cyclotron-bonn/nano_util_board/README.md

# nano_util_board
PCB design of the Arduino Nano-based util carrier board
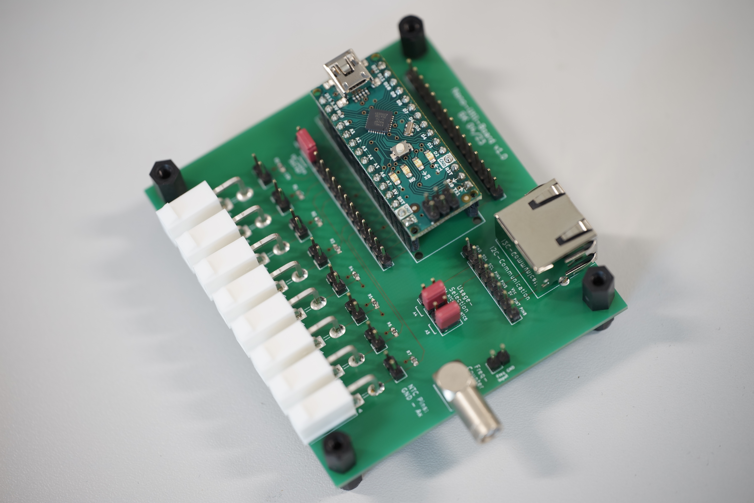
[picture p1: assets/Nano_util_board_v1_0_Birdeye.JPG]
nano_board_front


# KiCaD folder
This folder contains all the `.kicad_x` files necessary to display the schematic and pcb design in KiCaD.
A rendered 3d image `.png` of the PCB is also to be found in here, a `.pdf` of the schematic and a folder containing recent `.gbr` files.

# Further information
Information about the usage and programming can be found in the Wiki of this repository.
