cyclotron-bonn/nano_util_board/assets/Nano_util_board_v1_0_Topside_marked.JPG

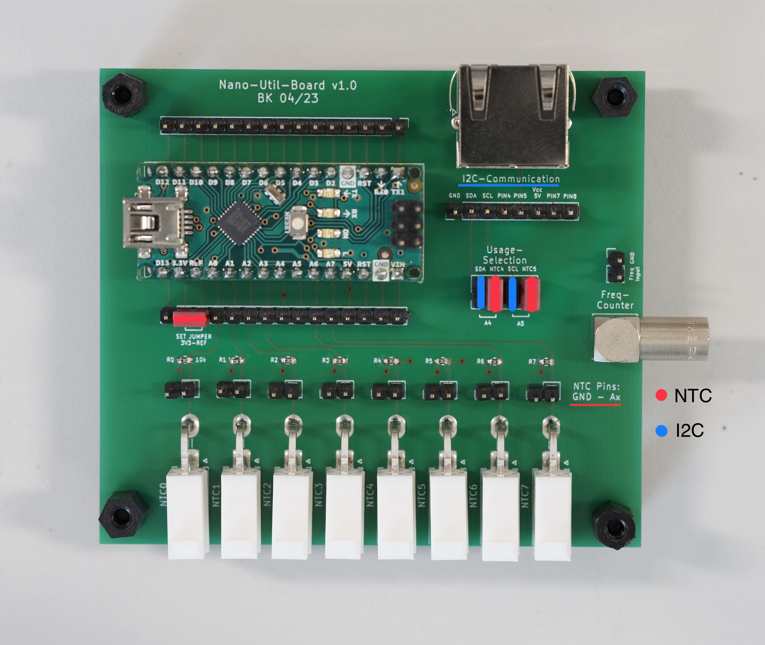
assets/Nano_util_board_v1_0_Topside_marked.JPG
