cyclotron-bonn/nano_util_board/KiCaD/nano_board/nano_board_back.png

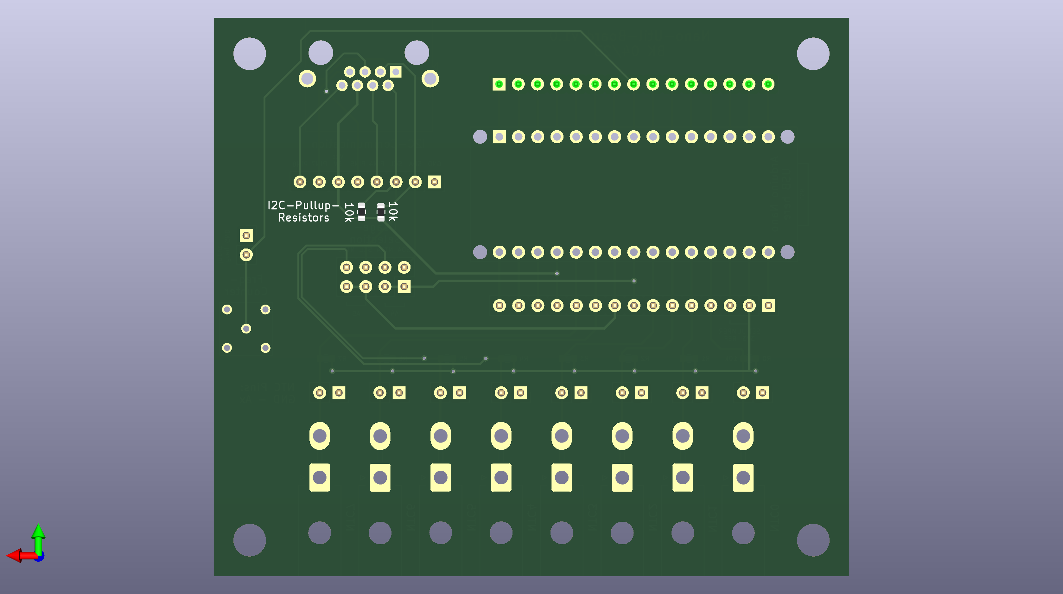
KiCaD/nano_board/nano_board_back.png
