cyclotron-bonn/nano_util_board/KiCaD/nano_board/nano_board.pdf

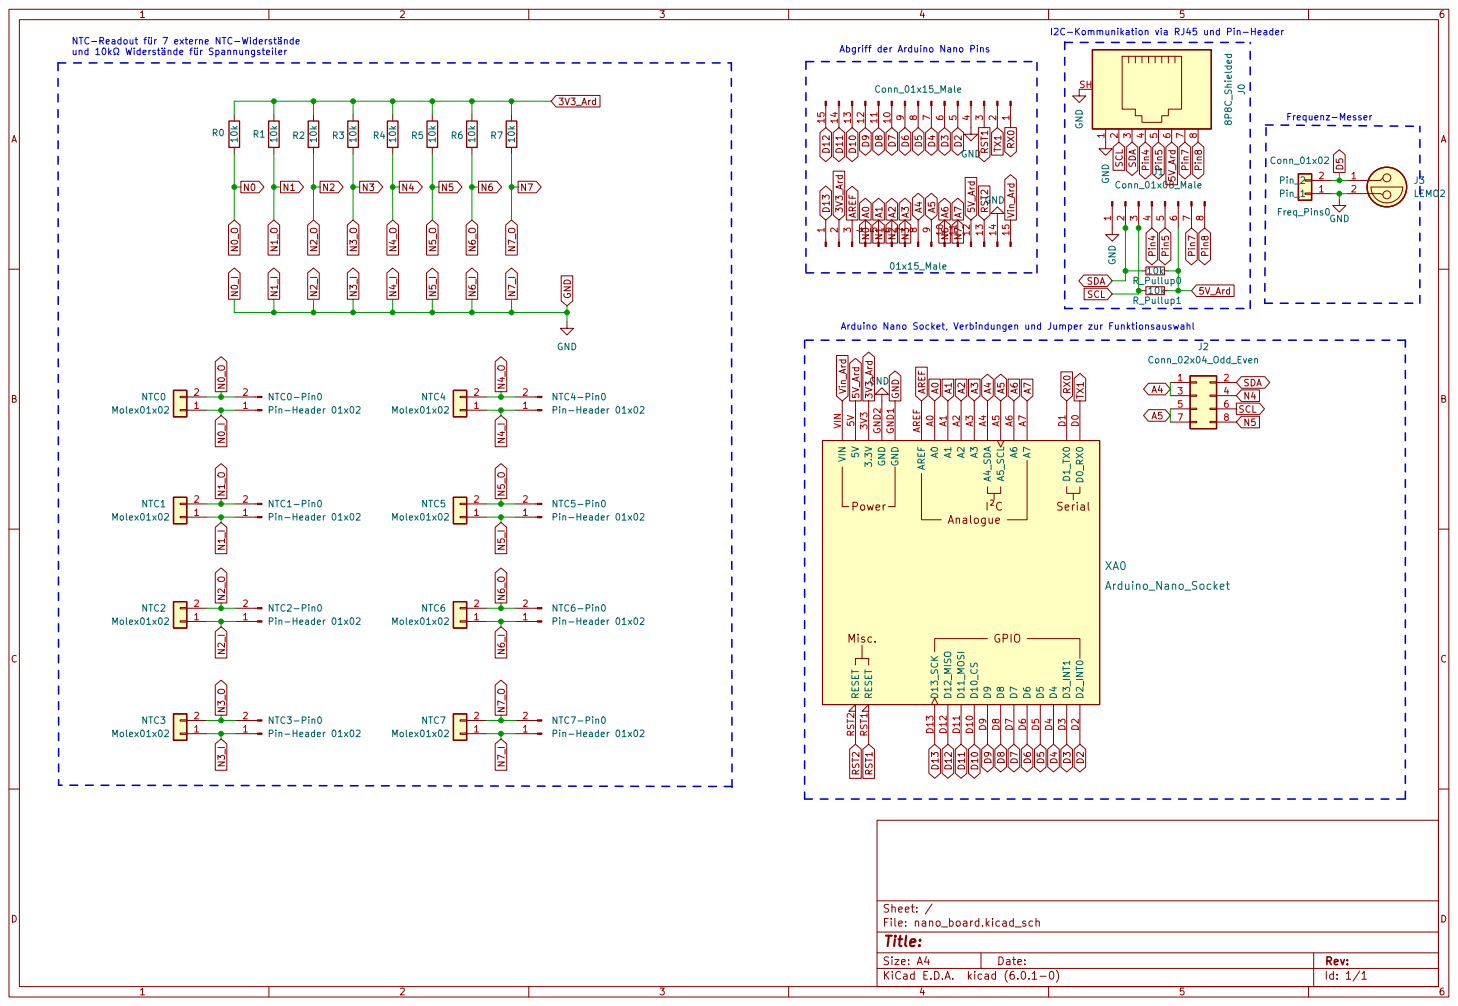
[picture p5: page 1]

Abgriff der Arduino Nano Pins þÿNTC-Readout für 7 externe NTC-Widerstände

I2C-Kommunikation via RJ45 und Pin-Header Arduino Nano Socket, Verbindungen und Jumper zur Funktionsauswahl
