cyclotron-bonn/nano_util_board/(threads)

Thread 1 (2022-08-31):

PCB: replace solder jumper with pin header

leloup314, 2022-08-31:
Replace the solder jumper which selects I2C VCC with a 3 pin header which then uses a jumper clip for selection

Closed 2022-09-02.

Thread 2 (2022-08-31):

PCB: add Lemo / BNC to connect freqency counting input

leloup314, 2022-08-31:
Additionally to the 2 pin header for the freq counter input, add a BNC / Lemo to connect to

bedakno, 2022-08-31:
Oh right, I forgot. Consider it done

Closed 2022-09-02.

Thread 3 (2022-08-31):

QUESTION: Resistor dimensions and arrangement of components

leloup314, 2022-08-31:
- Are you using 0603 footprints for the 10k resistors?
- Can you arrange the pin headers, that make all pins of the Nano available,  symmetrically around the Nano board?
- What is the current size of the PCB? Maybe you can make it a little bigger for the sake of accessibility when e.g. connecting NTCs

bedakno, 2022-08-31:
- yes
- ok, I rearranged most stuff so it fits onto a smaller PCB, but I guess accessability is important
- around 7.5x6 cm^2

Closed 2022-09-02.

Thread 4 (2022-08-31):

PCB: labels

leloup314, 2022-08-31:
Label e.g. the I2C pins individually with `VCC`, `GND`, `SDA`, and `SCL`. Label the Rj45 clearly as `R/O Board I2C Interface` or so, so people don't start to put random RJ45 cables in there ;)

Thread 6 (2022-09-02):

PCB: Sel-Pin-Freq Jumper not needed; VCC 3V3 to 5V needed

leloup314, 2022-09-02:
The Jumper Sel-Pin-Freq is not needed but it would be nice to set VCC of I2C to either 3V3 or 5V via such a jumper

Closed 2022-09-02.

Thread 8 (2022-09-02):

PCB: accessibility of PINs

leloup314, 2022-09-02:
The I2C Pin headers will not be easily accessible because of the adjacent RJ45 connector which is quite bulky, once on the PCB. Maybe you can relocate the I2C pin headers to be better accessible. It will be more easy to estimate if you place all the 3D components on the rendered image (if possible/available)

Closed 2022-09-02.

Thread 10 (2022-09-05):

PCB: Labels rename

leloup314, 2022-09-05:
- The I2C VCC select jumper should be named: `VCC select` and the pins just `5V` and `3V3`
- The pin names of the `5V` pin on the I2C pins should be renamed to `VCC`
- Finally, you should put the name and the version of the PCB as a label: `NanoUtilBoard v0.1`

Closed 2022-09-06.

Thread 11 (2022-09-05):

final edits v0.1

bedakno, 2022-09-05:
- lane clearence
- pin header clearence
- better label positioning and JUMPER 3V3-REF better
- GND as lane instead of layer

leloup314, 2022-09-05:
GND is fine a a plane, sorry, just talked to a colleague and he said it's the best solution

Closed 2022-09-06.

Thread 9 (2022-09-05):

PCB: indicate 3V3 - ARef Jumper needed for NTC operation

leloup314, 2022-09-05:
In the firmware of the NTC readout, it is expected that the ARef lies on 3V3. This should be indicated using a label on the PCB, that a Jumper must be set to connect pins 3V3 and ARef

leloup314, 2022-09-05:
Can you make brackets underneath the pins to jump so it is absolutely clear? ;)

Closed 2022-09-06.

Thread 12 (2022-09-06):

PCB: trace to GND pin

leloup314, 2022-09-06:
Can you connect the GND pin on the Nano to the respective pin on the upper header just for the sake of completeness? I know they are connected via the GND net on the backside already

Closed 2022-09-06.

Thread 14 (2022-09-06):

PCB: relocate Molex/RJ45 connector to edge of PCB

leloup314, 2022-09-06:
Can you relocate the Molex / Rj45 connector so that they (the outline) "stick out" 1-2 mm over the PCB? Makes it easier to connect things. (See the Lemo which also will stick out in the current PCB)

P.S.: You have to `git pull`, I removed the redundant frontside GND plane from the PCB

Closed 2022-09-06.

Thread 15 (2022-09-07):

Ideas for v0.2

bedakno, 2022-09-07:
- connect to Arduino via RJ45 on the board which can also be used as a power source

bedakno, 2022-11-07:
In a short presentation of the board it was commented that it would be helpful being able to hardware-reset the arduino from afar. That could be done via another RJ45 socket on the board which carries the serial signal and has one lane connected to one of the reset pins of the arduino.

leloup314, 2022-11-07:
Reset can always be done by just connecting to the Arduino headers directly. In any case, a custom cable has to be used / made, therefore it is just as good to use the headers directly imo

bedakno, 2022-11-08:
But how would one activate those pins in case the arduino isn't responding?

leloup314, 2022-11-08:
The hardware reset on the Arduino is done by pulling the RESET pin to GND. Therfore, you can just connect the pin headers RESET and GND to a wire each, solder these to a switch / button  which then shorts these pins on switch/push. This solution is still the same with an extra connector for reset

leloup314, 2022-11-08:
Or are we talking about different things ? ;)

leloup314, 2022-11-09:
Ok, I mean the same :) We can just use a cable as I said, patch it through the patch panel, and connect it to the GND and RESET pins, the short it via a button in the control room

leloup314, 2023-01-20:
Closing since v.02 is over ;)

Closed 2023-01-20.

Thread 16 (2022-09-17):

BUGs in v0.1

leloup314, 2022-09-17:
- Footprints of resistors appear to be 0201 instead of 0603
- Voltage divider potentials are switched: we used to measured the voltage drop over the NTC, now we measure over the fixed resistor (easily fixed in firmware)
- Maybe I2C issue (not working so far)

We received 4 PCBs, the NTC readout is wroking fine, the I2C to the R/O board is not yet working, the frequency counting needs some testing ;)

leloup314, 2022-09-17:
Also: when ordering the PCB, the company said that the _drill information_ was missing in the Gerber files (which were then added by our electronicslab)

bedakno, 2022-09-18:
Alright, I'll work on it. Are there any other enhancements I should add? See issue #15.

bedakno, 2022-09-18:
> Also: when ordering the PCB, the company said that the _drill information_ was missing in the Gerber files (which were then added by our electronicslab)

Oh, sorry for that. There is indeed an option for that in the export menu. So that should be a none issue next time

bedakno, 2022-09-21:
Should I swap NTC and 10k so that it'll be as intended before?

leloup314, 2022-09-21:
Yes please

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

bedakno, 2022-09-21:
Hopefully I fixed those issues. For now, I did **not** change the connection to the I2C RJ45, as I don't know how the correct pinout is. But changing this is no biggy as just the lanes would need to be changed.

leloup314, 2022-09-22:
I have the feeling that the I2C bus on the PCB is not working properly. We have a BA student who exactly uses NTC readout and I2C at the same time, using a breadboard. There it works whereas it does not with the PCB. So maybe the pinout for the RJ45 is correct but I2C is generally not working. Would be good if you meet with the BA student to check the breadboard schematic

leloup314, 2022-10-10:
@bedakno can you comment on the status of the PCB? Maybe a summary of what bugs have been identified and fixed and what has been tested?

leloup314, 2022-10-12:
It is good practice to `commit early & commit often`, would also be nice if you could push the fixes ;)

Closed 2022-10-14.

Thread 17 (2022-09-20):

PCB: remove VCC select pin hearder and add I2C select headers

leloup314, 2022-09-20:
When setting up I2C on the Nano, SDA and SCL are pulled high to 5V VCC. Therefore, the jumper to select VCC is not needed as it will always be 5V as default. On the other hand a jumper to exclusively connect A4 and A5 to either the I2C/Freq route or the NTC readout route should be added. Now The A4/A5 are permanently connected to GND via 10k which is probably not beneficial for reliable I2C comms

leloup314, 2022-10-10:
Is this done?

Closed 2022-10-14.

Thread 18 (2022-09-21):

PCB: add pull-up resistors for I2C

leloup314, 2022-09-21:
Due to the R/O board having pull-ups, I completely forgot that in a more general case you want to have pull-up resistors on the PCB itself ;)
Can you add 0603 10k pull-ups for SDA and SCL like [here](https://en.wikipedia.org/wiki/I%C2%B2C#/media/File:I2C_controller-target.svg)?

Closed 2022-09-21.

Thread 19 (2022-10-10):

TEST: Frequency counting

leloup314, 2022-10-10:
Please test whether the frequency counting works with the PCB / Nano.

bedakno, 2022-10-14:
I will try to work look into the issues I had while testing -> Communication with Arduino. From the pcb side, it should work, but who knows.

bedakno, 2023-04-24:
Was there a test confirming the Freq count works? Considering the feedback with the wrong pin, someone tried it out.

bedakno, 2023-04-24:
Internal communication confirmed working frequency counting :)

Closed 2023-04-24.

Thread 21 (2023-01-20):

DOC: write short documentation for basil

leloup314, 2023-01-20:
The `nano_util_board` is also used in SiLab by some projects. Here, the firm- and software are provided by the [basil DAQ framework](https://github.com/SiLab-Bonn/basil). A short PDF should be written (~ 1-2 pages) that can be hosted here as documentation.

bedakno, 2023-04-20:
I will begin to write documentation. Now that v1.0 has been reached..

bedakno, 2023-09-12:
I finalised the Wiki. Please have a look at it. I added quite a lot of text with the i2c programming (docstrings). I don't know if that's necessary.

bedakno, 2023-09-12:
Additionally, I didn't find the link to the ``.py`` script for the temperature readout on Basil, I only  found the ``.ino`` file.

leloup314, 2023-09-13:
Looks nice! Would be cool if you could add edits of the photos of which jumpers have to be present for what operation mode (e.g. i2c, ntc). Otherwise it is nice, the docstrings can stay. For basil, you can link to the examples

bedakno, 2023-09-18:
I edited the figures so that they include markings for each usecase.

Thread 22 (2023-03-01):

BUG: Frequency counting pin wrong

leloup314, 2023-03-01:
The pin which can be used fro frequency counting on the nano is **D5** aka pin 8, **not** A5. The frequency counter input should be rerouted to D5 and a new version should be made. The problems can be omitted by connecting D5 to the frequency input via the respective pin in the 2x5 header, thanks to @PatrickAhl

leloup314, 2023-03-02:
@bedakno please adjust the schematics accordingly when you find the time ;)

bedakno, 2023-03-02:
I corrected the mistake in the last commit (I forgot to reference the issue in the commit) and updated the schematic and PCB. New gerber files including drill holes have been uploaded. Also a new version was drafted to be released when the changes are found to be sufficient.

leloup314, 2023-03-03:
Nice, thanks! Now we don't need the 2x5 header anymore but a 2x4 header will suffice. Did you change that as well? I guess we can go for v1 if this is fixed.

Closed 2023-04-20.
