cyclotron-bonn/nano_util_board/(commit log)

2022-08-30 ADD:KiCaD files
    [nano_board.kicad_pcb, nano_board.kicad_sch]
2022-08-31 ENH: renames
    [nano_board.kicad_pcb]
2022-08-31 RM: remove doubles
    [nano_board.kicad_pcb, nano_board.kicad_sch]
2022-08-31 ENH:board ADD: image
    [nano_board.kicad_pcb]
2022-09-02 ENH: see issues #1 #2 #3 #4 #5
    [nano_board.kicad_pcb, nano_board.kicad_sch]
2022-09-02 ADD: schematic as .pdf
2022-09-02 ADD: schematic as pdf
    [nano_board.kicad_pcb, nano_board.kicad_sch]
2022-09-02 ENH: size of pcb printen on pcb
    [nano_board.kicad_pcb]
2022-09-02 ENH: #1 #2 #3 label placements and jumper changed
    [nano_board.kicad_pcb, nano_board.kicad_sch]
2022-09-05 ADD: jumper note #9
    [nano_board.kicad_pcb]
2022-09-05 ENH: align M4 Screwholes
    [nano_board.kicad_pcb]
2022-09-05 ENH: ground plane and connect all unconnected vias, run DRC
    [nano_board.kicad_pcb]
2022-09-05 RM:redundant images
    [nano_board.kicad_pcb, nano_board.kicad_sch]
2022-09-06 ENH: #9 #10 #11
    [nano_board.kicad_pcb]
2022-09-06 ENH: final tweaks v0.1
    [nano_board.kicad_pcb]
2022-09-06 ENH: change board name
    [nano_board.kicad_pcb]
2022-09-06 ENH:gnd pin con and other name ;-) #12 #13
    [nano_board.kicad_pcb]
2022-09-06 ENH: rm '1' from i2c label
    [nano_board.kicad_pcb]
2022-09-06 MAINT: remove GND plane from frontside
    [nano_board.kicad_pcb]
2022-09-06 ENH: moves ports to side of pcb #14
    [nano_board.kicad_pcb]
2022-09-06 ADD: gerberfiles v0.1 09/22
    [nano_board-B_Cu.gbr, nano_board-B_Mask.gbr, nano_board-B_Paste.gbr, nano_board-B_Silkscreen.gbr, nano_board-Edge_Cuts.gbr, nano_board-F_Cu.gbr, nano_board-F_Mask.gbr, nano_board-F_Paste.gbr]
2022-09-06 rename gerber folder
    [nano_board-B_Cu.gbr, nano_board-B_Mask.gbr, nano_board-B_Paste.gbr, nano_board-B_Silkscreen.gbr, nano_board-Edge_Cuts.gbr, nano_board-F_Cu.gbr, nano_board-F_Mask.gbr, nano_board-F_Paste.gbr]
2022-09-21 ENH: fix ntc voltage divider, add I2C pullup resistors and selection jumpers
    [nano_board.kicad_pcb, nano_board.kicad_sch]
2022-10-14 ENH:pcb labeling and rj45 footprint
    [nano_board.kicad_pcb]
2022-10-14 ENH:add up-to-date .pdf and .pngs of schematic and pcb
2022-10-18 ENH:correct arduino Vcc label
    [nano_board.kicad_pcb, nano_board.kicad_sch]
2022-11-24 ENH: pinheader for use-selection was redone; new board version: v0.3
    [nano_board-B_Cu.gbr, nano_board-B_Mask.gbr, nano_board-B_Paste.gbr, nano_board-B_Silkscreen.gbr, nano_board-Edge_Cuts.gbr, nano_board-F_Cu.gbr, nano_board-F_Mask.gbr, nano_board-F_Paste.gbr]
2022-11-24 ADD: update .pdf and .pngs of schematic and pcb
2022-11-24 DEL: wrongly placed directory
    [regelung_nano.kicad_pcb, regelung_nano.kicad_sch]
2022-11-27 ENH: rerouting and horizontal jumper selection
    [nano_board.kicad_pcb]
2022-11-28 DEL: delete old gerber file versions
    [nano_board-B_Cu.gbr, nano_board-B_Mask.gbr, nano_board-B_Paste.gbr, nano_board-B_Silkscreen.gbr, nano_board-Edge_Cuts.gbr, nano_board-F_Cu.gbr, nano_board-F_Mask.gbr, nano_board-F_Paste.gbr]
2022-11-28 ENH: enhanced routing
    [nano_board.kicad_pcb]
2022-11-28 ADD: gerbes files v0.3
    [nano_board-B_Cu.gbr, nano_board-B_Mask.gbr, nano_board-B_Paste.gbr, nano_board-B_Silkscreen.gbr, nano_board-Edge_Cuts.gbr, nano_board-F_Cu.gbr, nano_board-F_Mask.gbr, nano_board-F_Paste.gbr]
2022-11-28 MAINT: change gerber directory name
    [nano_board-B_Cu.gbr, nano_board-B_Mask.gbr, nano_board-B_Paste.gbr, nano_board-B_Silkscreen.gbr, nano_board-Edge_Cuts.gbr, nano_board-F_Cu.gbr, nano_board-F_Mask.gbr, nano_board-F_Paste.gbr]
2022-11-28 ENH: up-to date pcb
    [nano_board.kicad_pcb]
2022-11-29 ADD: gerber_files for v0.3 and small label enhancements
    [nano_board-B_Cu.gbr, nano_board-B_Mask.gbr, nano_board-B_Paste.gbr, nano_board-B_Silkscreen.gbr, nano_board-Edge_Cuts.gbr, nano_board-F_Cu.gbr, nano_board-F_Mask.gbr, nano_board-F_Paste.gbr]
2022-11-29 ENH: update board date
    [nano_board-B_Cu.gbr, nano_board-B_Mask.gbr, nano_board-B_Paste.gbr, nano_board-B_Silkscreen.gbr, nano_board-Edge_Cuts.gbr, nano_board-F_Cu.gbr, nano_board-F_Mask.gbr, nano_board-F_Paste.gbr]
2022-11-29 Update readme to include updated pcb-view
2023-03-02 FIX: connect freq pin to pin D5 not A5
    [nano_board-B_Cu.gbr, nano_board-B_Mask.gbr, nano_board-B_Paste.gbr, nano_board-B_Silkscreen.gbr, nano_board-Edge_Cuts.gbr, nano_board-F_Cu.gbr, nano_board-F_Mask.gbr, nano_board-F_Paste.gbr]
2023-04-20 ENH: add pins for RJ45 port, remove freq pin from header, update files #23,#24,#25
    [nano_board-B_Cu.gbr, nano_board-B_Mask.gbr, nano_board-B_Paste.gbr, nano_board-B_Silkscreen.gbr, nano_board-Edge_Cuts.gbr, nano_board-F_Cu.gbr, nano_board-F_Mask.gbr, nano_board-F_Paste.gbr]
2023-09-12 DEL: delete some KiCaD autosaves
2023-09-18 DEL: duplicate fp-info-cache from KiCaD
2023-09-18 ADD: create assets folder and upload image from pcb to it
